MG-5/ESP32-C3-Board/3D_files/ESP32-C3.step

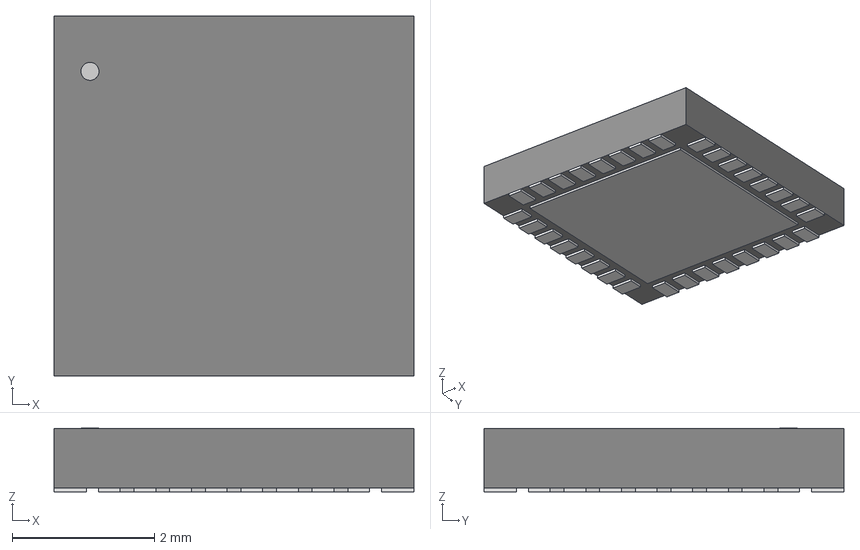
[picture p1: CAD file, 2025-02-11]
3D_files/ESP32-C3.step
5.05 x 5.05 x 0.892 mm
