MG-5/ESP32-C3-Board/3D_files/USB-C.stp

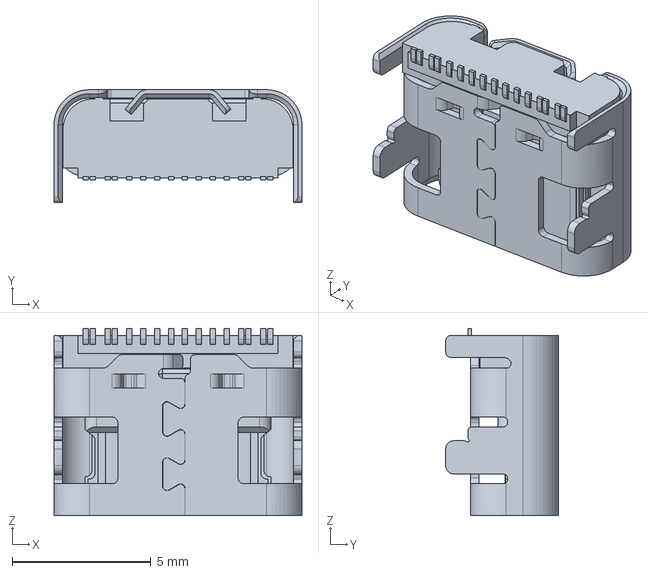
[picture p2: CAD file, 2025-02-11]
3D_files/USB-C.stp
8.94 x 4.06 x 6.75 mm
