MG-5/ESP32-C3-Board/(list of files, cad)

Other CAD files:
3D_files/ESP32-C3.stl
