MG-5/ESP32-C3-Board/ESP32-C3-Board.kicad_pcb

## KiCad design ESP32-C3-Board.kicad_pcb (2025-04-22)

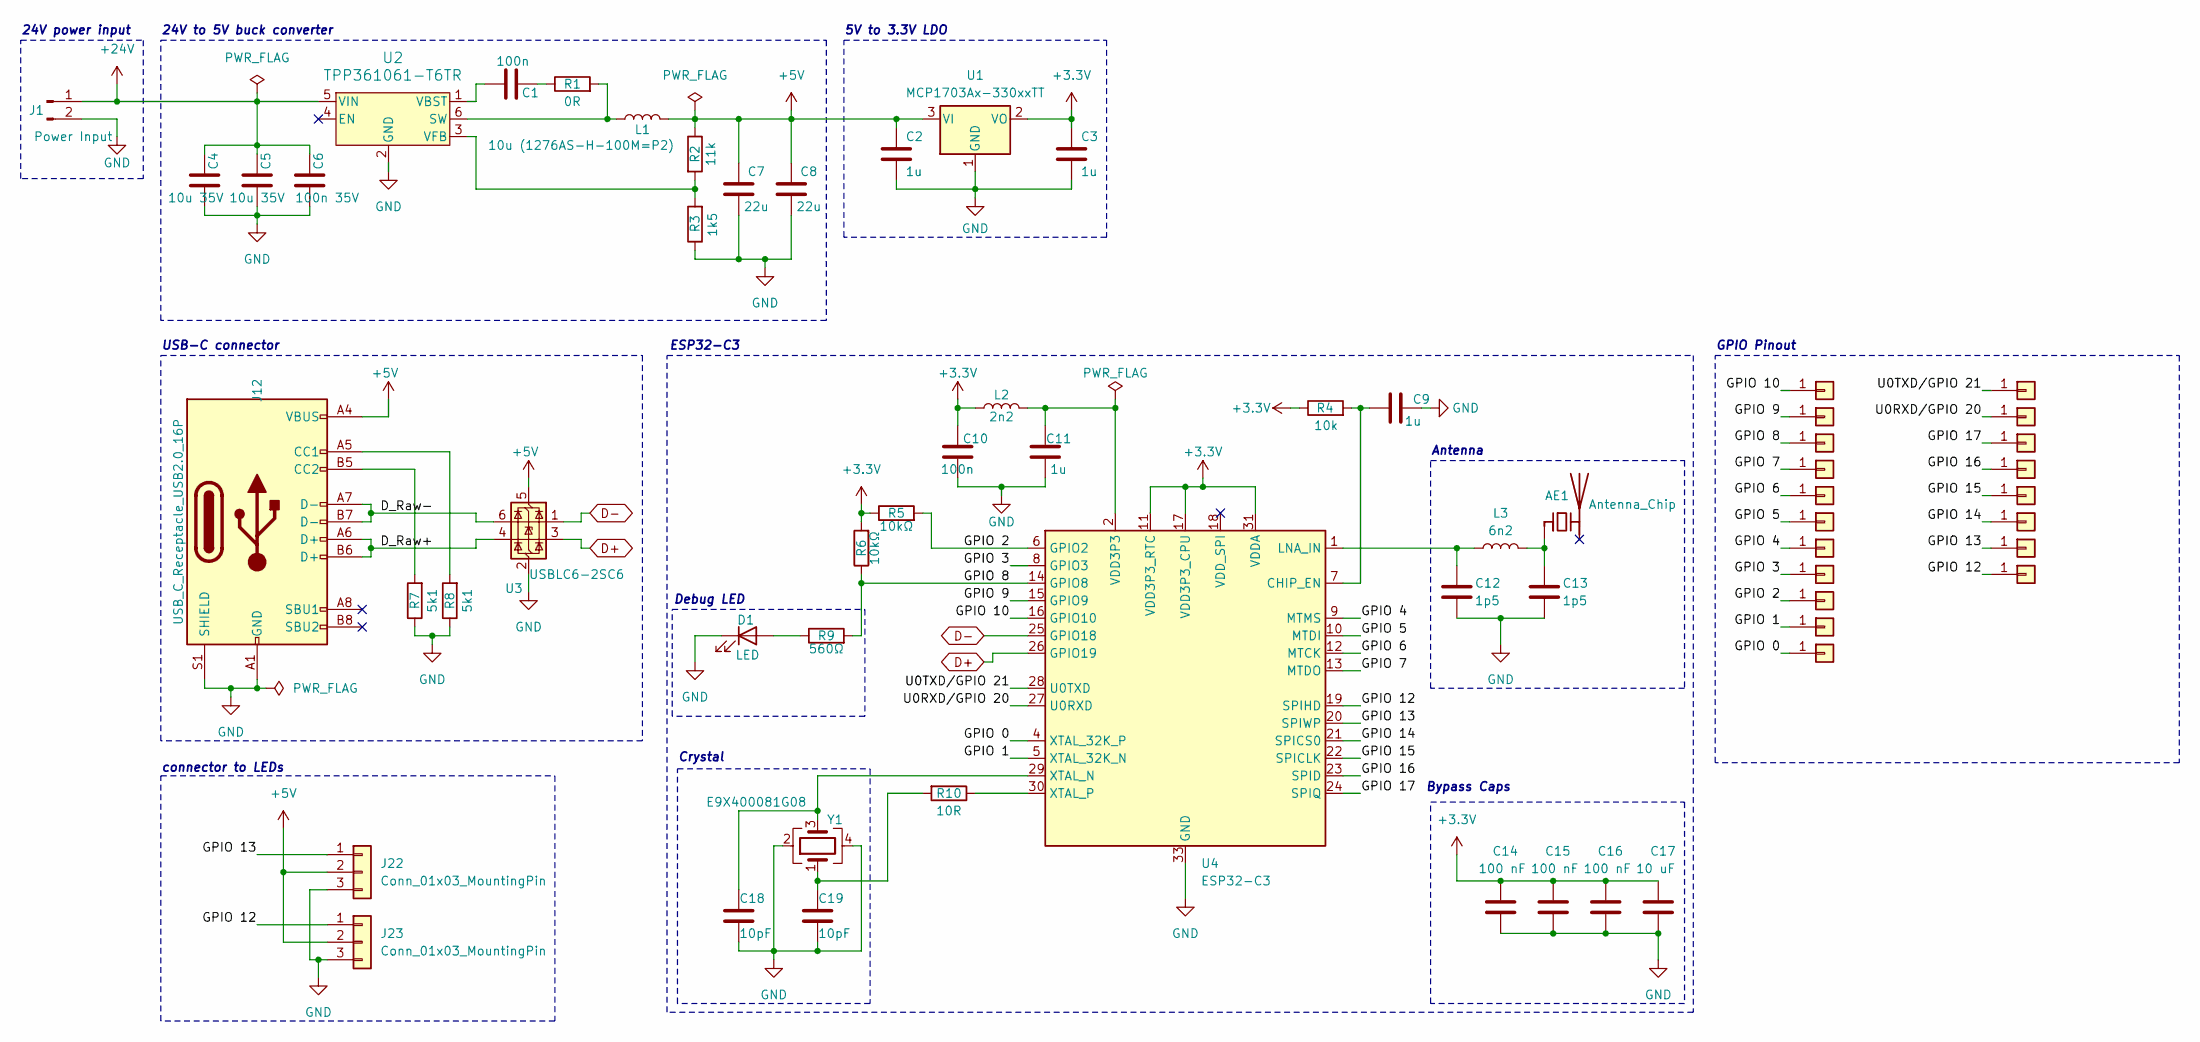
[picture p3: schematic ESP32-C3-Board.kicad_sch, ESP32-C3 LED PCB]

Parts:
AE1: Antenna_Chip; Johanson_2450AT43F0100
C1, C10: 100n; C_0603_1608Metric_Pad1.08x0.95mm_HandSolder
C2, C3, C9, C11: 1u; C_0603_1608Metric_Pad1.08x0.95mm_HandSolder
C4, C5: 10u 35V; C_0603_1608Metric_Pad1.08x0.95mm_HandSolder
C6: 100n 35V; C_0603_1608Metric_Pad1.08x0.95mm_HandSolder
C7, C8: 22u; C_0805_2012Metric_Pad1.18x1.45mm_HandSolder
C12, C13: 1p5; C_0402_1005Metric_Pad0.74x0.62mm_HandSolder
C14, C15, C16: 100 nF; C_0603_1608Metric_Pad1.08x0.95mm_HandSolder
C17: 10 uF; C_0603_1608Metric_Pad1.08x0.95mm_HandSolder
C18, C19: 10pF; C_0402_1005Metric_Pad0.74x0.62mm_HandSolder
D1: LED; LED_0805_2012Metric_Pad1.15x1.40mm_HandSolder
J1: Power Input; Molex_PicoBlade_53047-0210_1x02_P1.25mm_Vertical
J2, J3, J4, J5, J6, J7, J8, J9, J10, J11, J13, J14, J15, J16, J17, J18, J19, J20, J21: Conn_01x06; 01_P2.00mm
J12: USB_C_Receptacle_USB2.0_16P; USB_C_Receptacle_Palconn_UTC16-G
J22, J23: Conn_01x03_MountingPin; Molex_PicoBlade_53047-0310_1x03_P1.25mm_Vertical
L1: 10u (1276AS-H-100M=P2); L_1210_3225Metric_Pad1.42x2.65mm_HandSolder
L2: 2n2; L_0603_1608Metric
L3: 6n2; L_0402_1005Metric_Pad0.77x0.64mm_HandSolder
R1: 0R; R_0603_1608Metric_Pad0.98x0.95mm_HandSolder
R2: 11k; R_0603_1608Metric_Pad0.98x0.95mm_HandSolder
R3: 1k5; R_0603_1608Metric_Pad0.98x0.95mm_HandSolder
R4: 10k; R_0603_1608Metric_Pad0.98x0.95mm_HandSolder
R5, R6: 10kΩ; R_0603_1608Metric_Pad0.98x0.95mm_HandSolder
R7, R8: 5k1; R_0603_1608Metric_Pad0.98x0.95mm_HandSolder
R9: 560Ω; R_0603_1608Metric_Pad0.98x0.95mm_HandSolder
R10: 10R; R_0603_1608Metric_Pad0.98x0.95mm_HandSolder
U1: MCP1703Ax-330xxTT; SOT-23
U2: TPP361061-T6TR; SOT-23-6
U3: USBLC6-2SC6; SOT-23-6
U4: ESP32-C3; QFN-32-1EP_5x5mm_P0.5mm_EP3.7x3.7mm
Y1: E9X400081G08; Crystal_SMD_2016-4Pin_2.0x1.6mm

Connections:
+3.3V: C3.1, C10.1, C14.1, C15.1, C16.1, C17.1, L2.1, R4.1, R5.1, R6.2, U1.2 (VO), U4.11 (VDD3P3_RTC), U4.17 (VDD3P3_CPU), U4.31 (VDDA), U4.32 (VDDA)
+5V: C2.1, C7.2, C8.2, J12.A4 (VBUS), J12.A9 (VBUS), J12.B4 (VBUS), J12.B9 (VBUS), J22.2, J23.2, L1.1, R2.1, U1.3 (VI), U3.5 (VBUS)
+24V: C4.2, C5.2, C6.2, J1.1, U2.5 (VIN)
/D_Raw+: J12.A6 (D+), J12.B6 (D+), U3.4 (I/O2)
/D_Raw-: J12.A7 (D-), J12.B7 (D-), U3.6 (I/O1)
/GPIO 0: J21.1, U4.4 (XTAL_32K_P)
/GPIO 1: J20.1, U4.5 (XTAL_32K_N)
/GPIO 2: J19.1, R5.2, U4.6 (GPIO2)
/GPIO 3: J17.1, U4.8 (GPIO3)
/GPIO 4: J15.1, U4.9 (MTMS)
/GPIO 5: J13.1, U4.10 (MTDI)
/GPIO 6: J10.1, U4.12 (MTCK)
/GPIO 7: J8.1, U4.13 (MTDO)
/GPIO 8: J6.1, R6.1, R9.2, U4.14 (GPIO8)
/GPIO 9: J4.1, U4.15 (GPIO9)
/GPIO 10: J2.1, U4.16 (GPIO10)
/GPIO 12: J18.1, J23.1, U4.19 (SPIHD)
/GPIO 13: J16.1, J22.1, U4.20 (SPIWP)
/GPIO 14: J14.1, U4.21 (SPICS0)
/GPIO 15: J11.1, U4.22 (SPICLK)
/GPIO 16: J9.1, U4.23 (SPID)
/GPIO 17: J7.1, U4.24 (SPIQ)
/U0RXD/GPIO 20: J5.1, U4.27 (U0RXD)
/U0TXD/GPIO 21: J3.1, U4.28 (U0TXD)
D+: U3.3 (I/O2), U4.26 (GPIO19)
D-: U3.1 (I/O1), U4.25 (GPIO18)
GND: C2.2, C3.2, C4.1, C5.1, C6.1, C7.1, C8.1, C9.2, C10.2, C11.2, C12.2, C13.2, C14.2, C15.2, C16.2, C17.2, C18.2, C19.2, D1.1 (K), J1.2, J12.A1 (GND), J12.A12 (GND), J12.B1 (GND), J12.B12 (GND), J12.S1 (SHIELD), J22.3, J23.3, R3.1, R7.1, R8.1, U1.1 (GND), U2.2 (GND), U3.2 (GND), U4.33 (GND), Y1.2, Y1.4
unnamed: AE1.1 (FEED), C13.1, L3.2
unnamed: C1.2, R1.1
unnamed: C11.1, L2.2, U4.2 (VDD3P3), U4.3 (VDD3P3)
unnamed: C19.1, R10.2, Y1.1
unnamed: D1.2 (A), R9.1
unnamed: J12.A5 (CC1), R8.2
unnamed: J12.B5 (CC2), R7.2
unnamed: L1.2, R1.2, U2.6 (SW)
unnamed: C1.1, U2.1 (VBST)
unnamed: R2.2, R3.2, U2.3 (VFB)
unnamed: C9.1, R4.2, U4.7 (CHIP_EN)
unnamed: C12.1, L3.1, U4.1 (LNA_IN)
unnamed: C18.1, U4.29 (XTAL_N), Y1.3
unnamed: R10.1, U4.30 (XTAL_P)

Notes on the sheet:
Antenna
GPIO Pinout
Bypass Caps
Crystal
24V to 5V buck converter
USB-C connector
connector to LEDs
Debug LED
ESP32-C3
5V to 3.3V LDO
24V power input

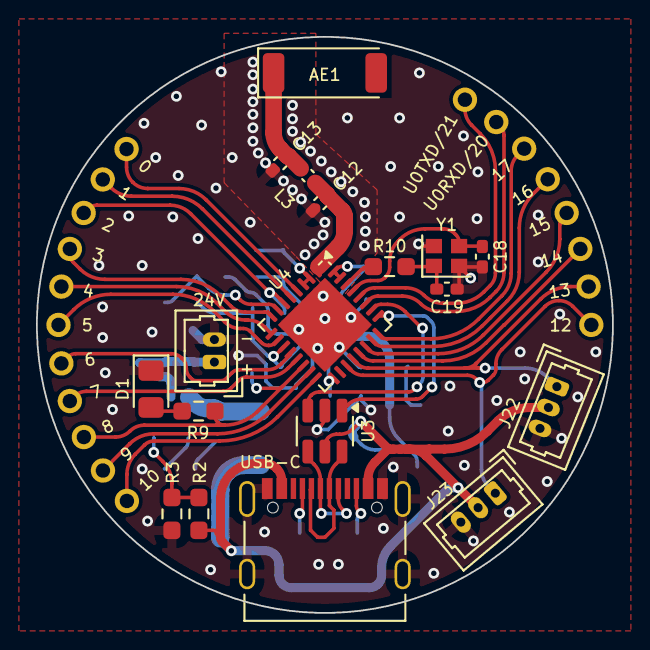
[picture p4: board ESP32-C3-Board.kicad_pcb from above]

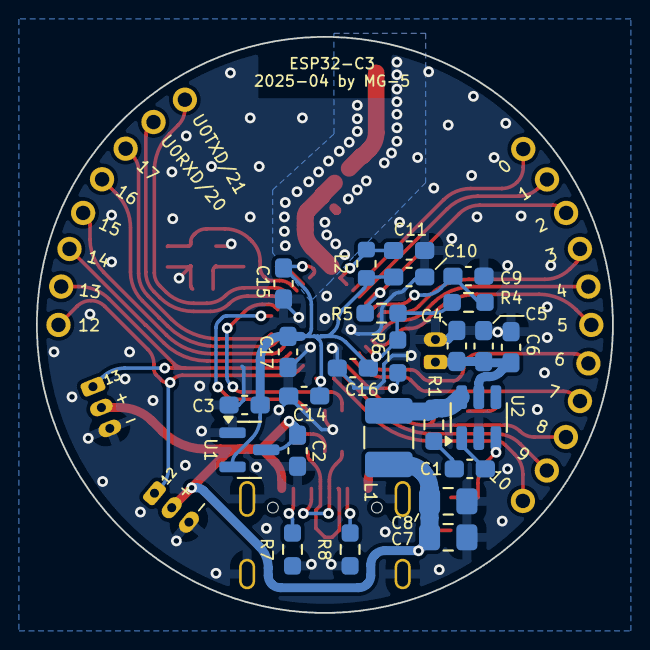
[picture p5: board ESP32-C3-Board.kicad_pcb from below]

Board: 2 copper layers, 32.0 x 32.0 mm, 62 parts (25 on the bottom side), 41 nets.
