MG-5/ESP32-C3-Board/(commit log)

2025-01-06 added KiCad files
    [KICad_Files.kicad_pcb, KICad_Files.kicad_sch, LED_Ring_PCB.kicad_sch]
2025-01-06 added board settings to the project file
    [KICad_Files.kicad_pcb]
2025-01-07 adjusted vias for better ground plane flow
    [KICad_Files.kicad_pcb]
2025-01-07 added more descriptions in the schematic
    [KICad_Files.kicad_sch]
2025-01-07 switched R8/R9 to 10kOhm resistors and properly named switches for Boot/Reset
    [KICad_Files.kicad_sch]
2025-01-26 rework of the PCB Layout
    [KICad_Files.kicad_pcb, KICad_Files.kicad_sch]
2025-01-27 fixed placement of silkscreen and improoved flow of the GND-plane
    [KICad_Files.kicad_pcb, KICad_Files.kicad_sch]
2025-01-27 added the correct values to the voltage divider
    [KICad_Files.kicad_sch]
2025-01-27 Added silkscreen Logo and Credits
    [KICad_Files-B_Cu.gbl, KICad_Files-B_Mask.gbs, KICad_Files-B_Paste.gbp, KICad_Files-B_Silkscreen.gbo, KICad_Files-Edge_Cuts.gm1, KICad_Files-F_Cu.gtl, KICad_Files-F_Mask.gts, KICad_Files-F_Paste.gtp]
2025-01-27 generated files for production with JLCPCB and removed old production files
    [KICad_Files-B_Cu.gbl, KICad_Files-B_Mask.gbs, KICad_Files-B_Paste.gbp, KICad_Files-B_Silkscreen.gbo, KICad_Files-Edge_Cuts.gm1, KICad_Files-F_Cu.gtl, KICad_Files-F_Mask.gts, KICad_Files-F_Paste.gtp]
2025-02-11 added names for the GPIO moved resistors for 5V USB to the front plane changed Logo from Nettz39 e.V. zu BlindDeerStudio Naming of GPIOS are still generic
    [ESP32-C3.step, ESP32-C3.stl, KICad_Files.kicad_pcb, USB-C.stp]
2025-02-12 Properly named all I/O Pins/ Power Pins on the Back fixed some minor errors where the silkscreen wasnt aligned properly
    [KICad_Files.kicad_pcb]
2025-02-13 Fixed Voltage Divider values in PCB Editor
    [KICad_Files.kicad_pcb]
2025-02-17 added multiple components for proper operation of the ESP added 40 mHz crystal added a connector for UART Changed LED placement to GPIO8 for use as Debug LED
    [KICad_Files.kicad_sch]
2025-02-25 added footprints to the added parts
    [KICad_Files.kicad_sch]
2025-02-25 Fixed ground connection to 5V error
    [KICad_Files.kicad_sch]
2025-02-27 Complete rework of the PCB routing
    [KICad_Files.kicad_pcb, KICad_Files.kicad_sch]
2025-02-27 Fixed errors and silkscreen overlapping
    [KICad_Files.kicad_pcb]
2025-02-27 removed some loose tracks
    [KICad_Files.kicad_pcb]
2025-04-22 Redesign Add 24V buck converter
    [KICad_Files-B_Cu.gbl, KICad_Files-B_Mask.gbs, KICad_Files-B_Paste.gbp, KICad_Files-B_Silkscreen.gbo, KICad_Files-Edge_Cuts.gm1, KICad_Files-F_Cu.gtl, KICad_Files-F_Mask.gts, KICad_Files-F_Paste.gtp]
2025-04-22 Rename/move files
    [ESP32-C3-Board.kicad_pcb, ESP32-C3-Board.kicad_sch, LED_Ring_PCB.kicad_sch]
